jf-psu/PSU_ECE411_2018_Team8/README.md

# PSU_ECE411_2018_Team8
Fall 2018 Practicum Project for Portland State University

Please see the [Wiki](https://github.com/jf-psu/PSU_ECE411_2018_Team8/wiki) for more information.
