jf-psu/PSU_ECE411_2018_Team8/documents/team8_solar_tester_bill_of_materials.ods

Bill Of Materials for Team 8 Solar Tester
source file: team8_solar_tester.sch
Last modified: 20-NOV-2018
PCB version: 1.0 |  | P/DNP = | Place/Do Not Place component
BOM revision: 1.0
Cnt | Part References | P/DNP | Mfg | Mfg PN | Description | Distributor | Dist. PN | Cost Ea. | Cost Ext. | Notes
6 | C1, C2, C5, C6, C7, C12 | P | Yageo | CC0603KRX7R7BB104 | 0.1uF 10% 16V 0603 capacitor | Mouser | 603-CC603KRX7R7BB104 | $0.12 | $0.72
3 | C8, C13, C14 | P | Yageo | CC0603KRX7R7BB105 | 1uF 10% 16V 0603 capacitor | Mouser | 603-CC603KRX7R7BB105 | $0.21 | $0.63
2 | C9, C10 | P | KEMET | C0603C220K4GACAUTO | 22pF 10% 16V 0603 capacitor | Mouser | 80-C0603C220K4GAUTO | $0.28 | $0.56
2 | C3, C4 | P | Murata | GRM21BC81C106KE15L | 10uF 10% 16V 0805 capacitor | Mouser | 81-GRM21BC81C106KE5L | $0.30 | $0.60
1 | C11 | P | TDK | C2012JB1A226M085AC | 22uF 20% 10V 0805 capacitor | Mouser | 810-C2012JB1A226M08C | $0.70 | $0.70
2 | R12, R13 | P | Yageo | RC0603JR-070RL | 0 ohm 5% 1/10W 0603 resistor | Mouser | 603-RC0603JR-070RL | $0.10 | $0.20
1 | R1 | P | Yageo | RL1210FR-070R1L | 0.1 ohm 1% 1/2W 1210 resistor | Mouser | 603-RL1210FR070R1L | $0.68 | $0.68
2 | R10, R11 | P | Susumu | RR0816Q-100-D | 10 ohm 0.5% 1/16W 0603 resistor | Mouser | 754-RR0816Q-100D | $0.10 | $0.20
2 | R14, R15 | P | Yageo | RC0603FR-0722RL | 22 ohm 1% 1/10W 0603 resistor | Mouser | 603-RC0603FR-0722RL | $0.10 | $0.20
3 | R8, R16, R17 | P | Yageo | RC0603FR-071KL | 1K ohm 1% 1/10W 0603 resistor | Mouser | 603-RC0603FR-071KL | $0.10 | $0.30
2 | R2, R3 | P | Yageo | RC0603FR-074K7L | 4.7K ohm 1% 1/10W 0603 resistor | Mouser | 603-RC0603FR-074K7L | $0.10 | $0.20
5 | R4, R5, R6, R7, R9 | P | Yageo | RC0603FR-0710KL | 10K ohm 1% 1/10W 0603 resistor | Mouser | 603-RC0603FR-0710KL | $0.10 | $0.50
1 | FB1 | P | TDK | MPZ1608D300BTD25 | Ferrite Bead 0603 30ohms 1800mA | Mouser | 810-MPZ1608D300BTD25 | $0.10 | $0.10
1 | VR1 | P | Vishay | TS53YJ502MR10 | 5K ohm TS53 5K trimmer | Mouser | 72-TS53YJ-5K | $1.29 | $1.29
1 | F1 | P | Littelfuse | 0805L050WR | Polyfuse PPTC 0.50A 6V 0805 | Mouser | 576-0805L050 | $2.55 | $2.55
1 | Y1 | P | ECS | ECS-160-18-30B-AGN-TR | 16MHz 25ppm 18pF Crystal 5x3.2mm | Mouser | 520-160-18-30B-AGNT | $0.58 | $0.58
1 | U1 | P | Atmel | ATMEGA32U4-MU | AVR MCU USB 32K Flash QFN44 | Mouser | 556-ATMEGA32U4-MU | $4.10 | $4.10
1 | IC1 | P | Texas Instruments | INA219BIDR | Current & Power Monitor SOIC8 | Mouser | 595-INA219BIDR | $2.34 | $2.34
2 | Q1, Q2 | P | ON Semiconductor | FQP30N06L | MOSFET 60V N-Channel QFET Logic Level | Mouser | 512-FQP30N06L | $1.22 | $2.44
1 | D1 | P | Wurth Electronics | 150060BS75000 | 0603 Blue LED | Mouser | 710-150060BS75000 | $0.16 | $0.16
1 | D2 | P | Wurth Electronics | 150060GS75000 | 0603 Green LED | Mouser | 710-150060GS75000 | $0.14 | $0.14
1 | J1 | P | Amphenol FCI | 10104110-0001LF | Micro USB Type B Receptacle | Mouser | 649-10104110-0001LF | $0.76 | $0.76
1 | S1 | P | TE Connectivity | 2-1825910-7 | Tactile Switch 6MM | Mouser | 506-2-1825910-7 | $0.13 | $0.13
1 | J3+J4 | P | Pomona | 6883 | Red and Black Binding Posts | Mouser | 565-6883 | $3.69 | $3.69
0 | J2 | DNP | Molex | 10-89-7061 | 2X3 .1” header | Mouser | 538-10-89-7061 | $0.39 | $-
0 | J11 | DNP | Molex | 10-89-7081 | 2X4 .1” header | Mouser | 538-10-89-7081 | $0.52 | $-
 |  |  |  |  |  |  | TOTAL COST: |  | $23.77
Ver # | Changed in version
1 | Initial BOM.
