jf-psu/PSU_ECE411_2018_Team8/schematic/team8_solar_tester.pdf

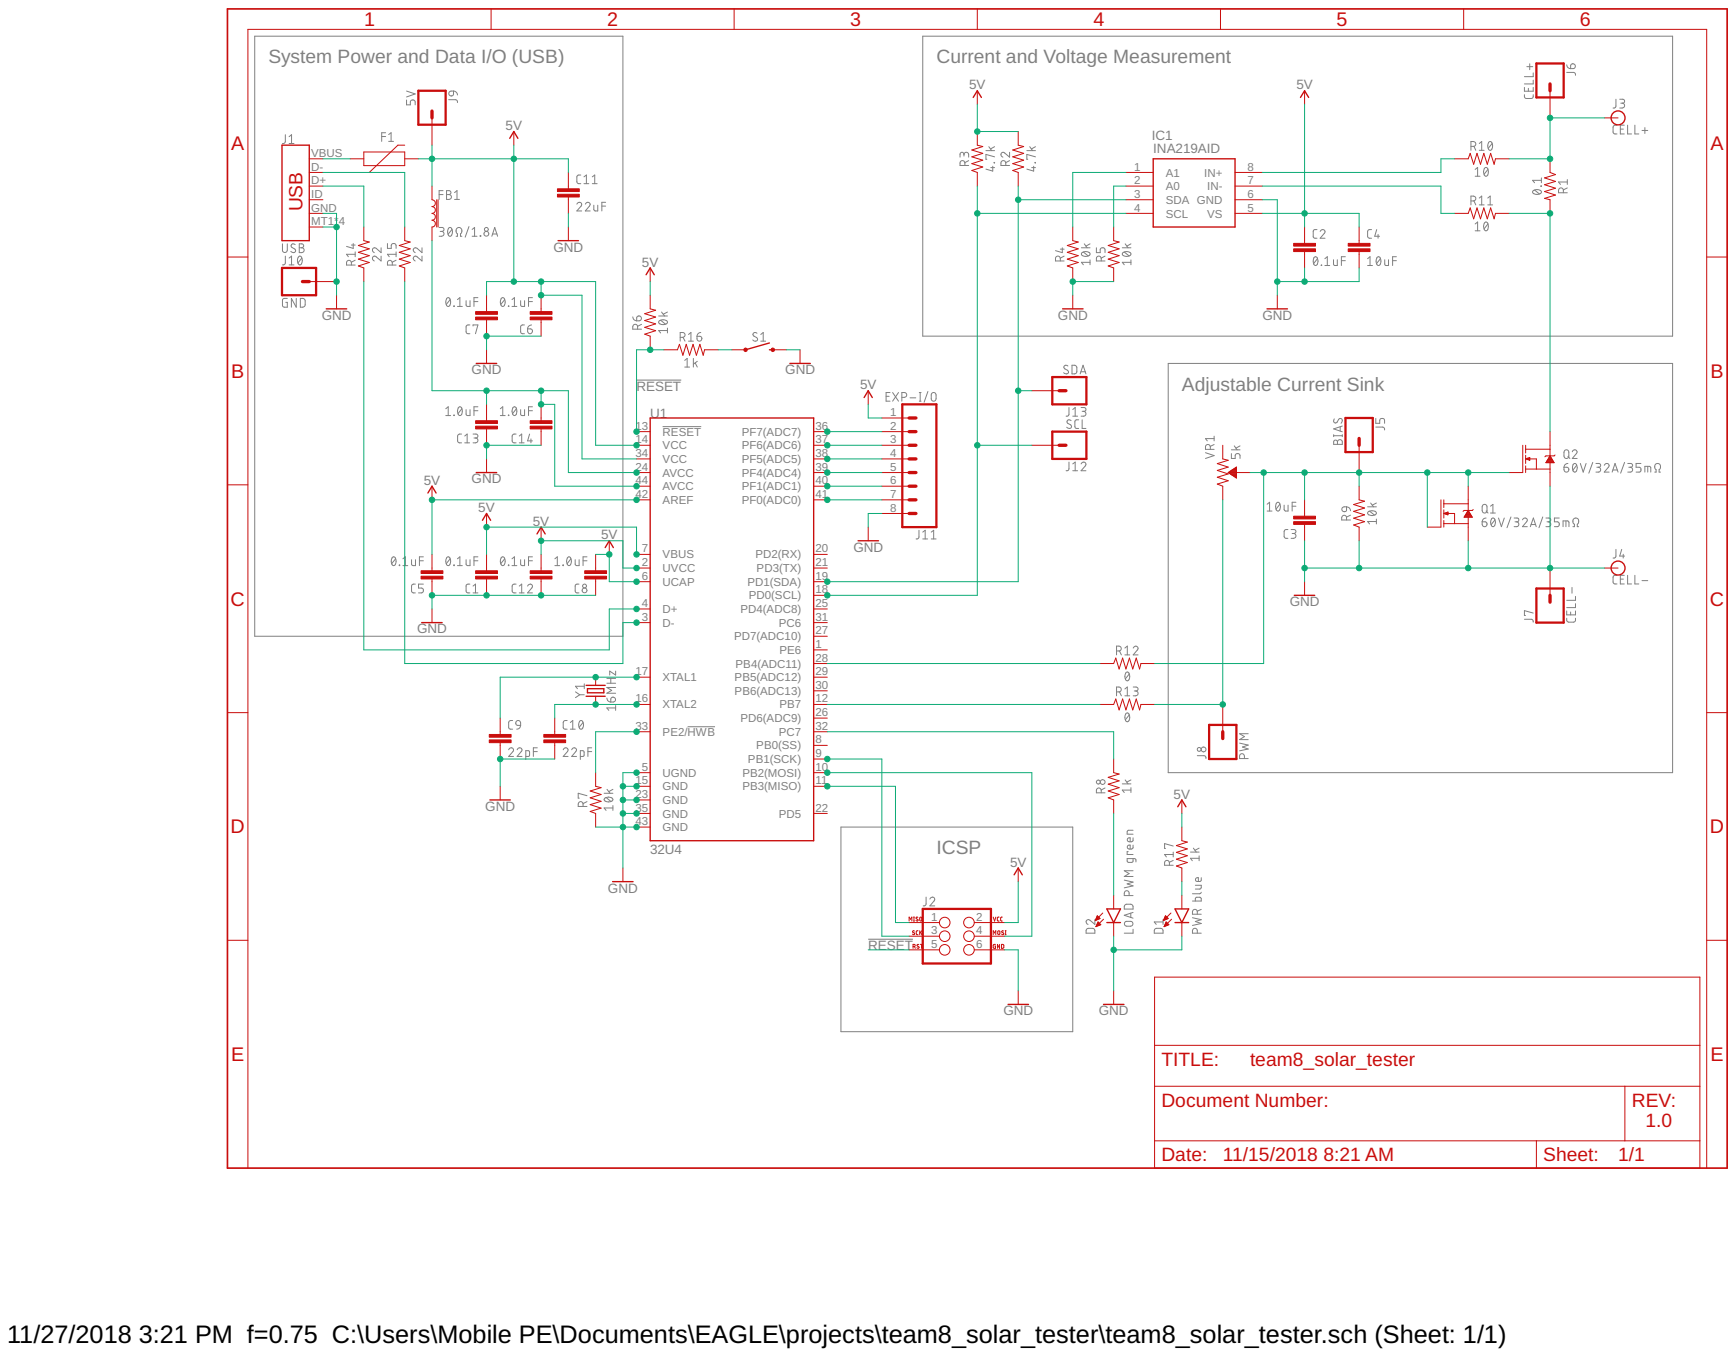
[picture p8: page 1]

System Power and Data I/O (USB) | | Current and Voltage Measurement

11/27/2018 3:21 PM f=0.75 C:\Users\Mobile PE\Documents\EAGLE\projects\team8_solar_tester\team8_solar_tester.sch (Sheet: 1/1)
