jf-psu/PSU_ECE411_2018_Team8/circuit_board/team8_solar_tester.brd

## EAGLE design circuit_board/team8_solar_tester.brd (2018-11-15)

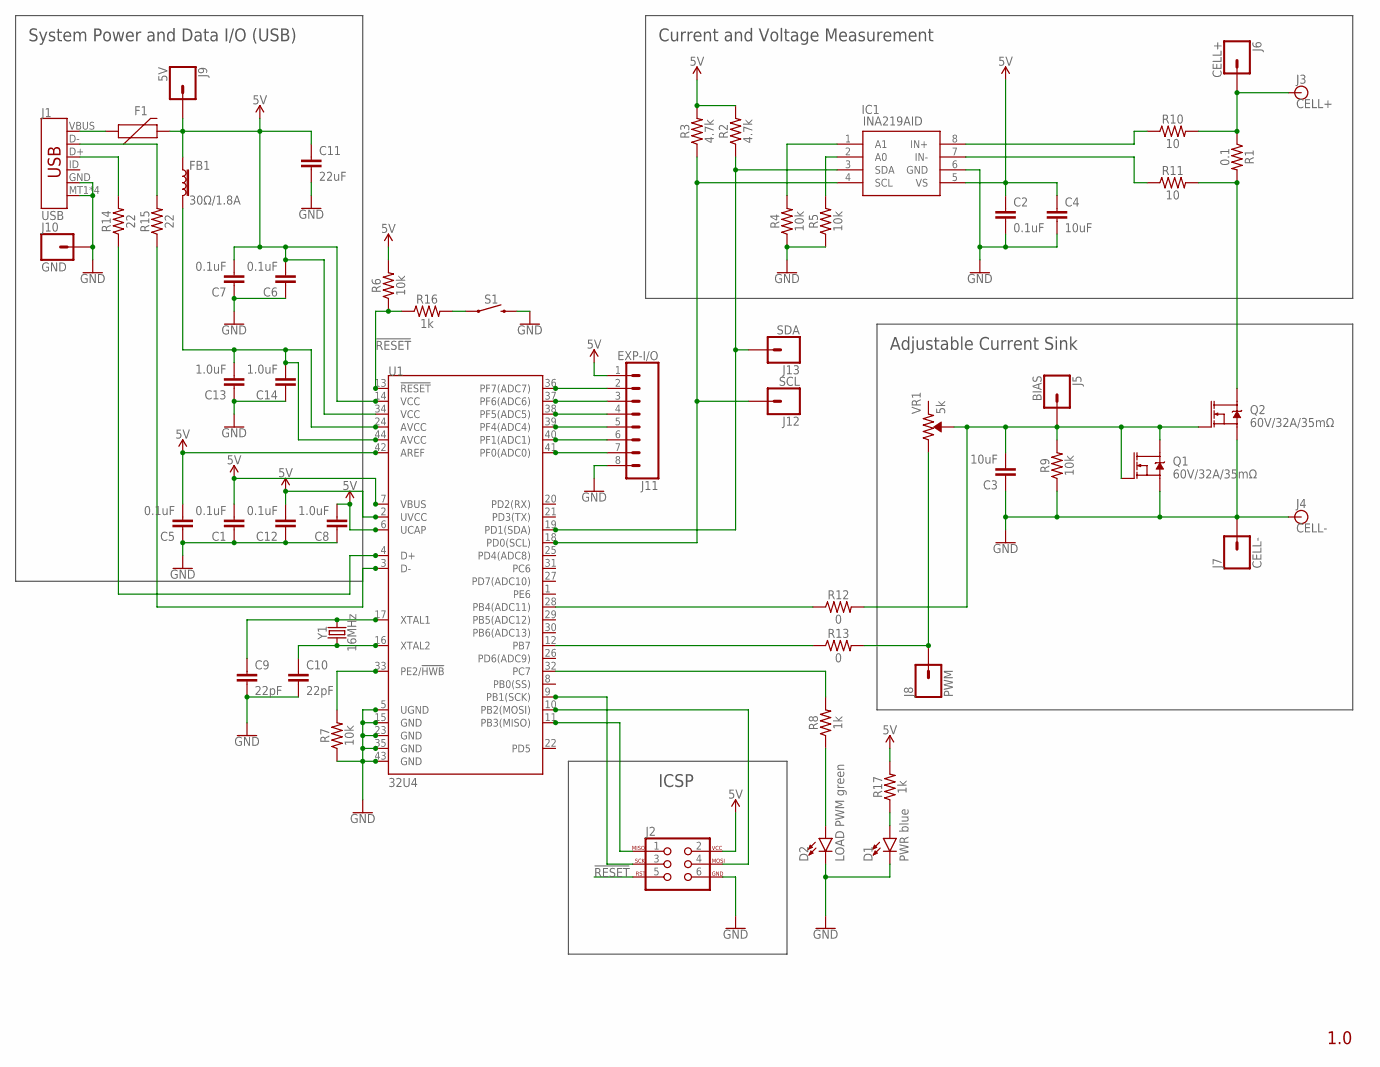
[picture p9: schematic team8_solar_tester.sch]

Parts:
C1, C2, C5, C6, C7, C12: 0.1uF; 0603
C3, C4: 10uF; 0805
C8, C13, C14: 1.0uF; 0603
C9, C10: 22pF; 0603
C11: 22uF; 0805
D1: PWR blue; LED-0603
D2: LOAD PWM green; LED-0603
F1: PPTC_6V500MA; 0805
FB1: 30Ω/1.8A; 0603
IC1: INA219AID; SOIC127P600X175-8N
J1: USB; USB-MICROB
J2: AVR_SPI_PROG_3X2PTH; 2X3
J3: CELL+; BANANA_CONN
J4: CELL-; BANANA_CONN
J5: BIAS; 1X01
J6: CELL+; 1X01
J7: CELL-; 1X01
J8: PWM; 1X01
J9: 5V; 1X01
J10: GND; 1X01
J11: EXP-I/O; 1X08_LONGPADS
J12: SCL; 1X01
J13: SDA; 1X01
Q1, Q2: 60V/32A/35mΩ; TO220V
R1: 0.1; 1210
R2, R3: 4.7k; 0603
R4, R5, R6, R7, R9: 10k; 0603
R8, R16, R17: 1k; 0603
R10, R11: 10; 0603
R12, R13: 0; 0603
R14, R15: 22; 0603
S1: MOMENTARY-SWITCH-SPST-PTH-6.0MM; TACTILE_SWITCH_PTH_6.0MM
U1: 32U4; QFN-44
VR1: 5k; TRIMPOT-SMD-5MM
Y1: 16MHz; CRYSTAL-SMD-5X3.2-4PAD

Connections:
5V: C1.2, C2.1, C4.1, C5.2, C6.2, C7.2, C8.2, C11.1, C12.2, F1.2, FB1.1, IC1.5 (VS), J2.2, J9.1, J11.1, R2.2, R3.2, R6.2, R17.2, U1.2 (UVCC), U1.6 (UCAP), U1.7 (VBUS), U1.14 (VCC), U1.34 (VCC), U1.42 (AREF)
!RESET!: J2.5, R6.1, R16.1, U1.13 (!RESET)
AVCC: C13.2, C14.2, FB1.2, U1.24 (AVCC), U1.44 (AVCC)
BEFORE_FUSE: F1.1, J1.VBUS
GND: C1.1, C2.2, C3.1, C4.2, C5.1, C6.1, C7.1, C8.1, C9.2, C10.2, C11.2, C12.1, C13.1, C14.1, D1.C, D2.C, IC1.6 (GND), J1.GND, J1.MT1 (SHIELD), J1.MT2 (SHIELD), J1.P$1 (SHIELD), J1.P$2 (SHIELD), J2.6, J4.P$1, J7.1, J10.1, J11.8, Q1.3 (S), Q2.3 (S), R4.1, R5.1, R7.1, R9.1, S1.3 (2), U1.5 (UGND), U1.15 (GND), U1.23 (GND), U1.35 (GND), U1.43 (GND)
unnamed: Q2.2 (D), R1.2, R11.2
unnamed: J3.P$1, J6.1, R1.1, R10.2
unnamed: IC1.2 (A0), R5.2
unnamed: IC1.1 (A1), R4.2
unnamed: J11.7, U1.41 (PF0(ADC0))
unnamed: IC1.4 (SCL), J12.1, R3.1, U1.18 (PD0(SCL))
unnamed: IC1.8 (IN+), R10.1
unnamed: IC1.7 (IN-), R11.1
unnamed: R13.1, U1.12 (PB7)
unnamed: J2.1, U1.11 (PB3(MISO))
unnamed: J2.4, U1.10 (PB2(MOSI))
unnamed: J2.3, U1.9 (PB1(SCK))
unnamed: R12.1, U1.28 (PB4(ADC11))
unnamed: J8.1, R13.2, VR1.C (CW)
unnamed: J1.D+, R14.2
unnamed: J1.D-, R15.2
unnamed: J11.6, U1.40 (PF1(ADC1))
unnamed: R15.1, U1.3 (D-)
unnamed: R14.1, U1.4 (D+)
unnamed: C10.1, U1.16 (XTAL2), Y1.1
unnamed: C9.1, U1.17 (XTAL1), Y1.3 (2)
unnamed: R16.2, S1.1
unnamed: IC1.3 (SDA), J13.1, R2.1, U1.19 (PD1(SDA))
unnamed: C3.2, J5.1, Q1.1 (G), Q1.2 (D), Q2.1 (G), R9.2, R12.2, VR1.B (WIPER)
unnamed: J11.5, U1.39 (PF4(ADC4))
unnamed: J11.4, U1.38 (PF5(ADC5))
unnamed: J11.3, U1.37 (PF6(ADC6))
unnamed: J11.2, U1.36 (PF7(ADC7))
unnamed: R7.2, U1.33 (PE2/!HWB)
unnamed: R8.2, U1.32 (PC7)
unnamed: D2.A, R8.1
unnamed: D1.A, R17.1

Notes on the sheet:
Current and Voltage Measurement
Adjustable Current Sink
ICSP
System Power and Data I/O (USB)

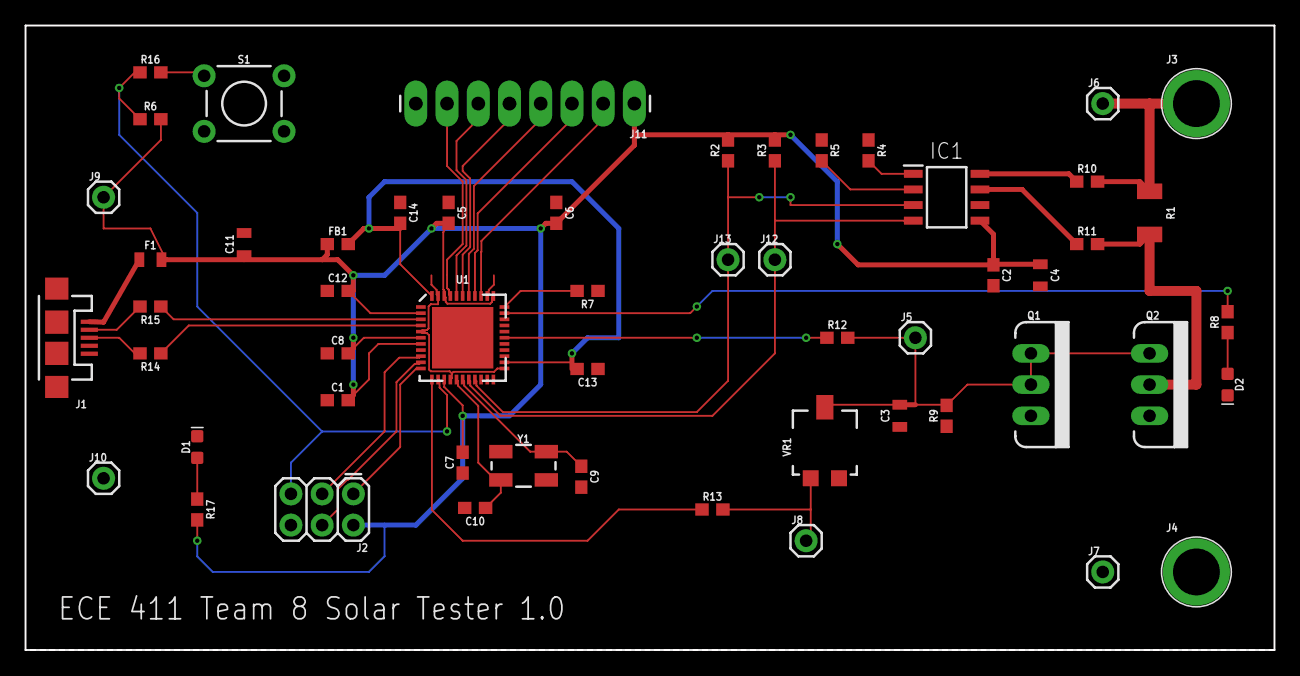
[picture p10: board team8_solar_tester.brd from above]

Board: 2 copper layers, 101.6 x 50.8 mm, 55 parts (0 on the bottom side), 37 nets.
