jf-psu/PSU_ECE411_2018_Team8/circuit_board/team8_solar_tester.png

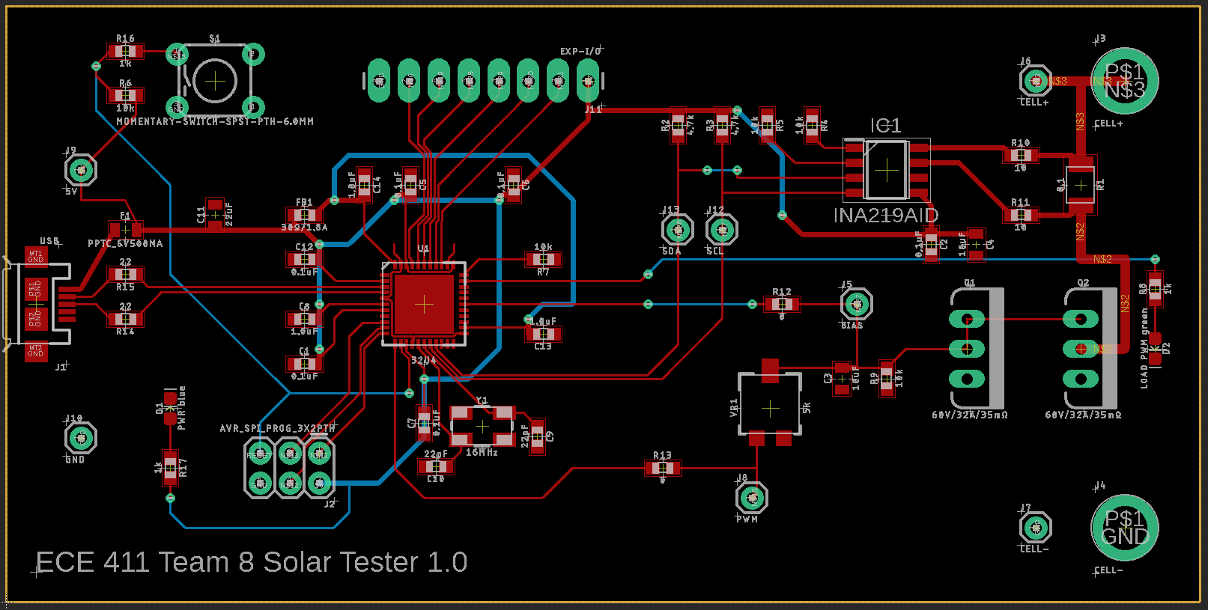
circuit_board/team8_solar_tester.png
