jf-psu/PSU_ECE411_2018_Team8/software/ui.py

from PyQt5.QtCore import Qt
from PyQt5 import QtGui  # (the example applies equally well to PySide)
import pyqtgraph as pg
import time
import serial

def collect_trace():
    trace_btn.setEnabled(False)
    app.setOverrideCursor(Qt.WaitCursor)

    print('Starting trace')

    com_port = 'COM5'

    print('Opening serial port %s' % com_port)
    ser = serial.Serial(com_port, 2000000)
    ser.flush()
    print('Sending (G)O command')
    ser.write('G'.encode())

    print('Collecting I-V trace')
    print('PWM_Value Voltage Current Bias_Voltage')

    voltage = []
    current = []
    power = []
    data_point = [] 

    for i in range(0, 256 * 5):
        line = ser.readline()
        print(line.decode('ascii').strip())

        #PWM_Value Voltage Current Bias_Voltage
        #0 1.05 0.23 0

        data = line.split()
        v = float(data[1])
        c = float(data[2])
        p = v * c
        data_point.append((v,c,p))

        voltage.append(v)
        current.append(c)
        power.append(p)

        iv_curve.setData(x=voltage, y=current)
        power_curve.setData(x=voltage, y=power)

        app.processEvents()

    print('Closing serial port')
    ser.close()

    print('Trace complete')
    trace_btn.setEnabled(True)
    app.restoreOverrideCursor()



#self.timer = QtCore.QTimer()
#        self.timer.timeout.connect(self.updateplot)
#        self.timer.start(self._interval)
  #plot.addItem(y=1,x=1)
  
## Always start by initializing Qt (only once per application)
app = QtGui.QApplication([])

## Define a top-level widget to hold everything
w = QtGui.QWidget()
w.setWindowTitle('ECE 411 Team 8 Solar Tester')
## Create some widgets to be placed inside
trace_btn = QtGui.QPushButton('&Trace')
trace_btn.clicked.connect(collect_trace)
plot_widget = pg.PlotWidget(title='Title')
plot_widget.addLegend()
plot_widget.setLabel('left', 'Current', units='mA')
plot_widget.setLabel('bottom', 'Voltage', units='V')
plot_widget.setLabel('right', 'Power', units='mW')

plot_widget.showGrid(x=True)

# disable mouse input on plot? this doesn't work:
#plot.setMouseEnabled(x=None, y=None)

iv_curve = plot_widget.plot([0,0], pen='b', line=None, symbol='o', symbolPen='b', symbolBrush=0.5, name='I-V')
iv_curve.clear()
iv_curve.getViewBox().invertX(True)
#enableAutoScale()
power_curve = plot_widget.plot([0,0], pen='r', line=None, fillLevel=0, fillBrush=(255,255,255,30), name='Power')
power_curve.clear()
#power_curve.getAxis('right').linkToView(p2)
## Create a grid layout to manage the widgets size and position
layout = QtGui.QGridLayout()
w.setLayout(layout)

## Add widgets to the layout in their proper positions
layout.addWidget(trace_btn, 0, 0)   # button goes in upper-left
#layout.addWidget(text, 1, 0)   # text edit goes in middle-left
#layout.addWidget(listw, 2, 0)  # list widget goes in bottom-left
layout.addWidget(plot_widget, 0, 1, 3, 1)  # plot goes on right side, spanning 3 rows

## Display the widget as a new window
w.show()

## Start the Qt event loop
app.exec_()
