jf-psu/PSU_ECE411_2018_Team8/(commit log)

2018-10-25 Update schematics/solar_tester.sch
    First rough draft based on Arduino Micro design.
    [solar_tester.sch]
2018-11-05 Update and rename adruino read I2C.cpp to software/adruino read I2C.cpp
2018-11-15 Adding the final schematic and board
    [solar_tester.sch, team8_solar_tester.brd, team8_solar_tester.sch]
2018-12-03 Adding BOM
    [team8_solar_tester_bill_of_materials.ods]
2018-12-03 Adding PDF version of schematic
2018-12-03 Added power sensor reading command
2018-12-03 Create counter arduino
2018-12-05 Do averaging on PC rather than device
2018-12-05 Adding picture of board layout
